jeanpri/303/pictures/04 - final assembly/IMG_6313_result.jpg

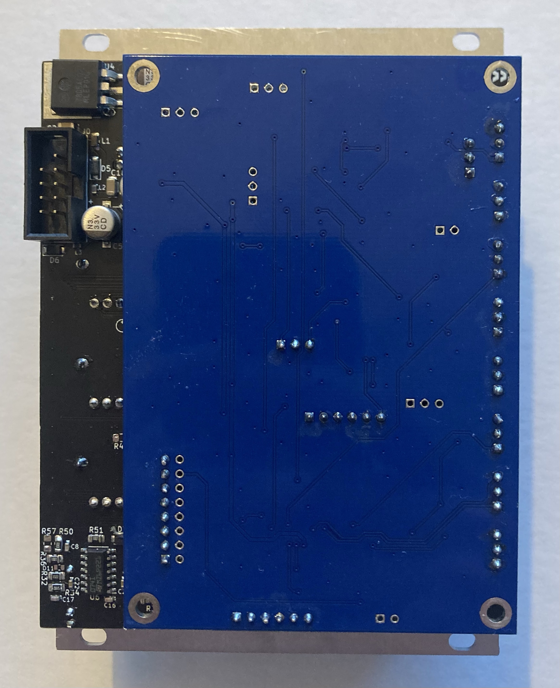
pictures/04 - final assembly/IMG_6313_result.jpg
