jeanpri/303/pictures/03 - x0x-hearth/IMG_6323_result.jpg

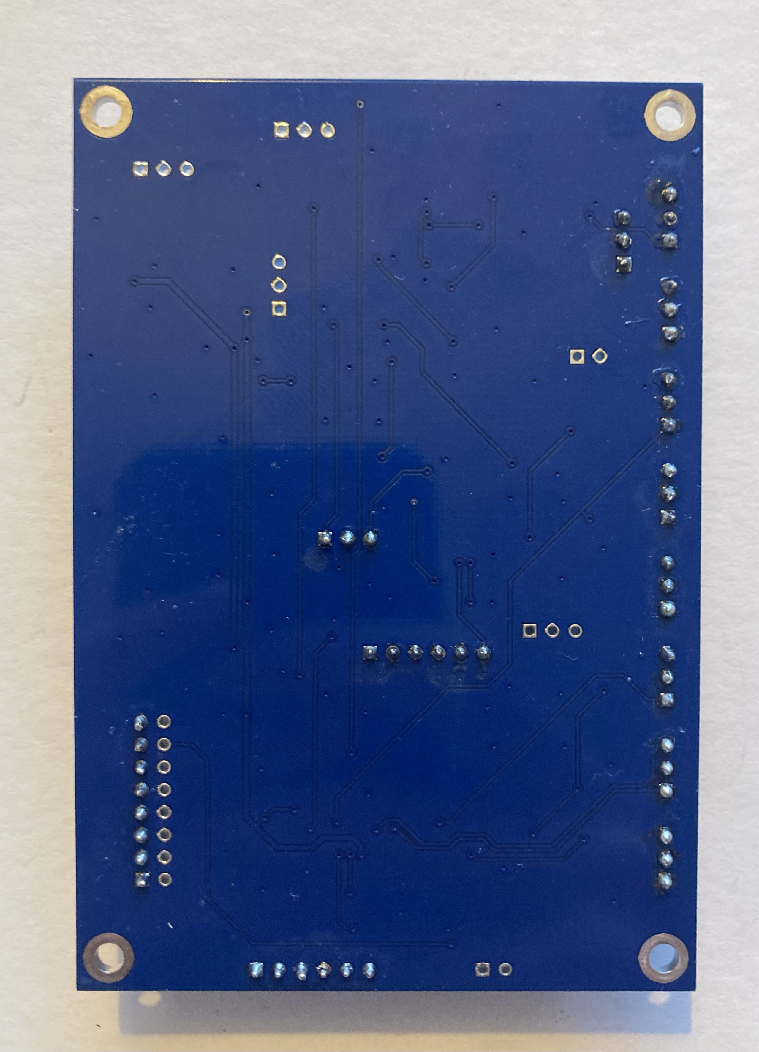
pictures/03 - x0x-hearth/IMG_6323_result.jpg
