jeanpri/303/CIRCUIT UPDATE R50 R52.pdf

## December 17, 2024

# IMPORTANT UPDATE

# Correction: Resistor Value Update

The VCA output sound was faulty: the low frequencies were filtered (the VCF output is OK).

The previously listed value of the resistor was incorrect.
R50
Incorrect Value: 330Ω
Correct Value: 51KΩ
R52
Incorrect Value: 1KΩ
Correct Value: 68KΩ

I've also updated the documentation and files in the repository to reflect this change.
