jeanpri/303/production files/interface 303/PCB info.pdf

Material: FR-4
Layers: 2
Dimension: 109mm* 90mm
Thickness: 1.6mm
Via Covering: Tented
Surface Finish: HASL(with lead)
