jeanpri/303/production files/panel 303/PCB info.pdf

Material: Aluminium (or FR-4) Layers: 1
Dimension: 128.5mm* 91.3mm Thickness: 2mm (or 1.6mm)
PCB Color : black
Silkscreen : white
