jeanpri/303/pictures/FRONT.jpg

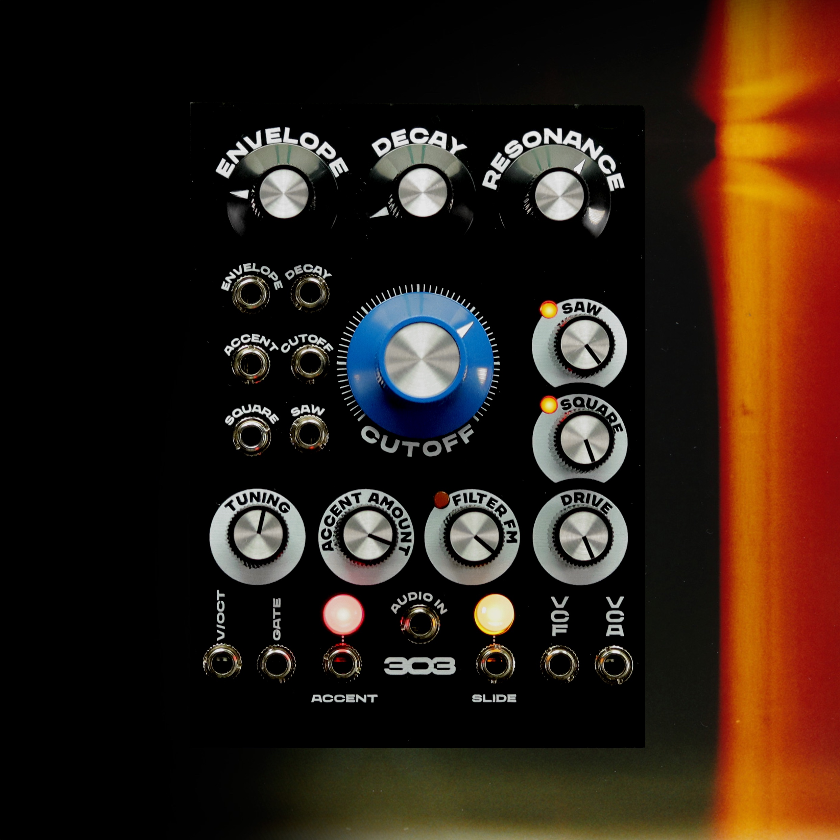
pictures/FRONT.jpg
