jeanpri/303/pictures/SIDE.jpg

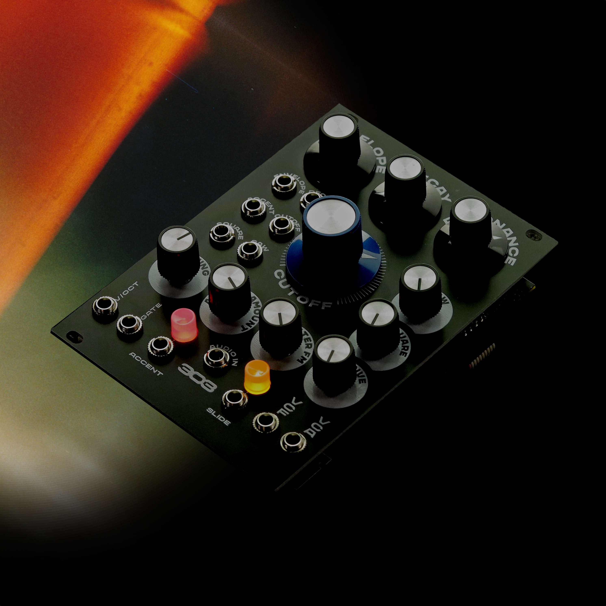
pictures/SIDE.jpg
