jeanpri/303/production files/panel 303 v2/303 panel v2.png

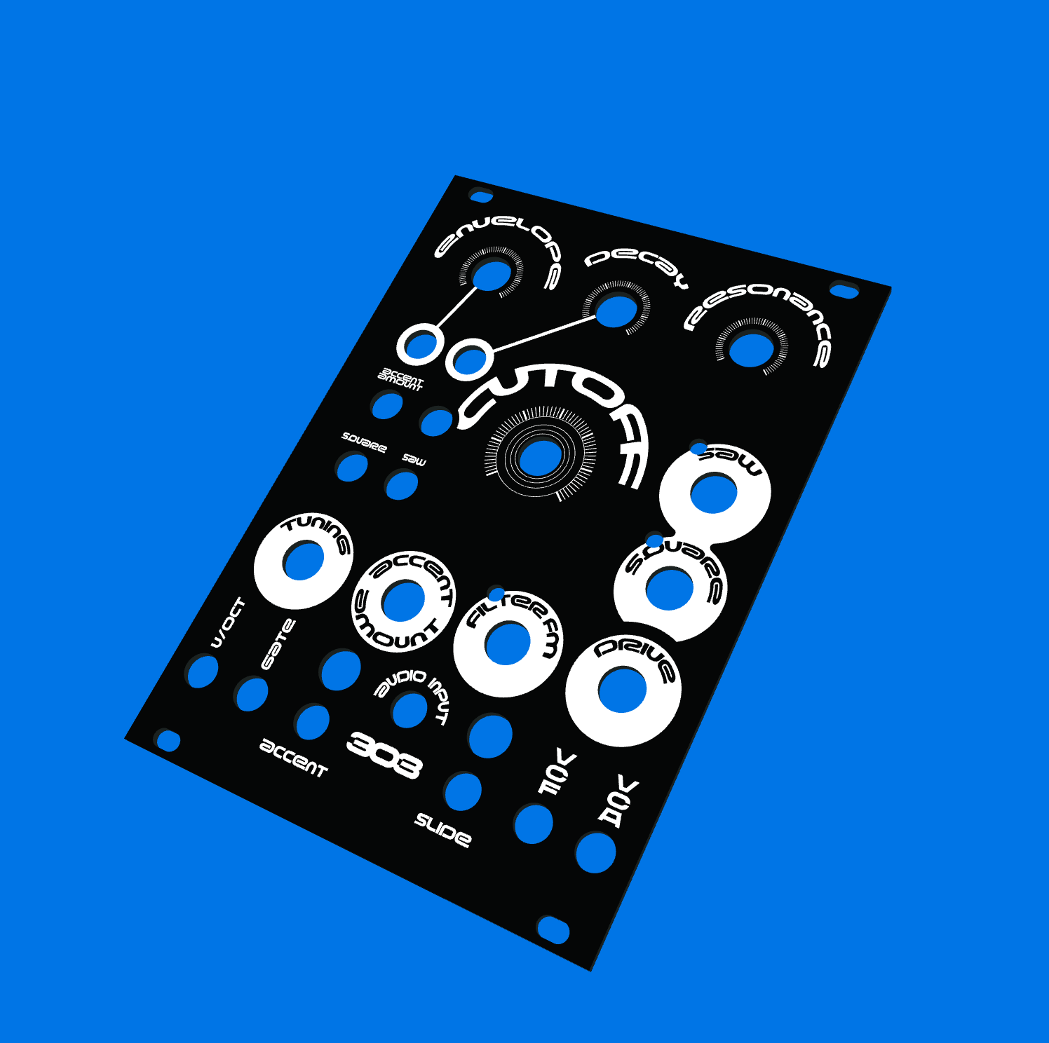
production files/panel 303 v2/303 panel v2.png
