jeanpri/303/source files/interface 303/3D bottom.png

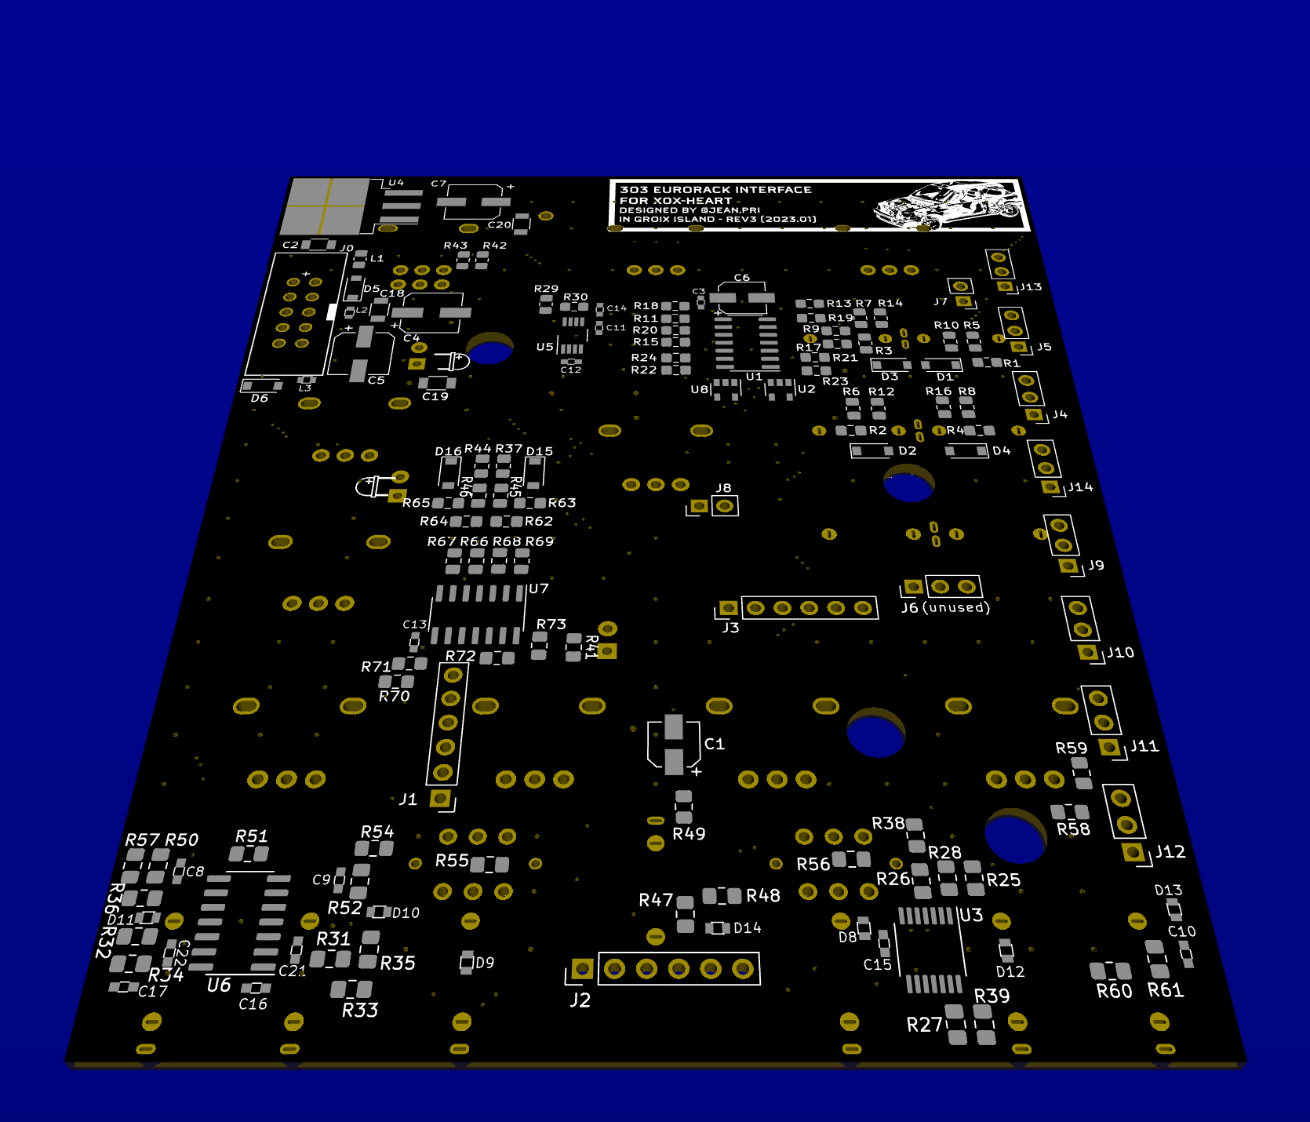
source files/interface 303/3D bottom.png
