jeanpri/303/source files/interface 303/3D top.png

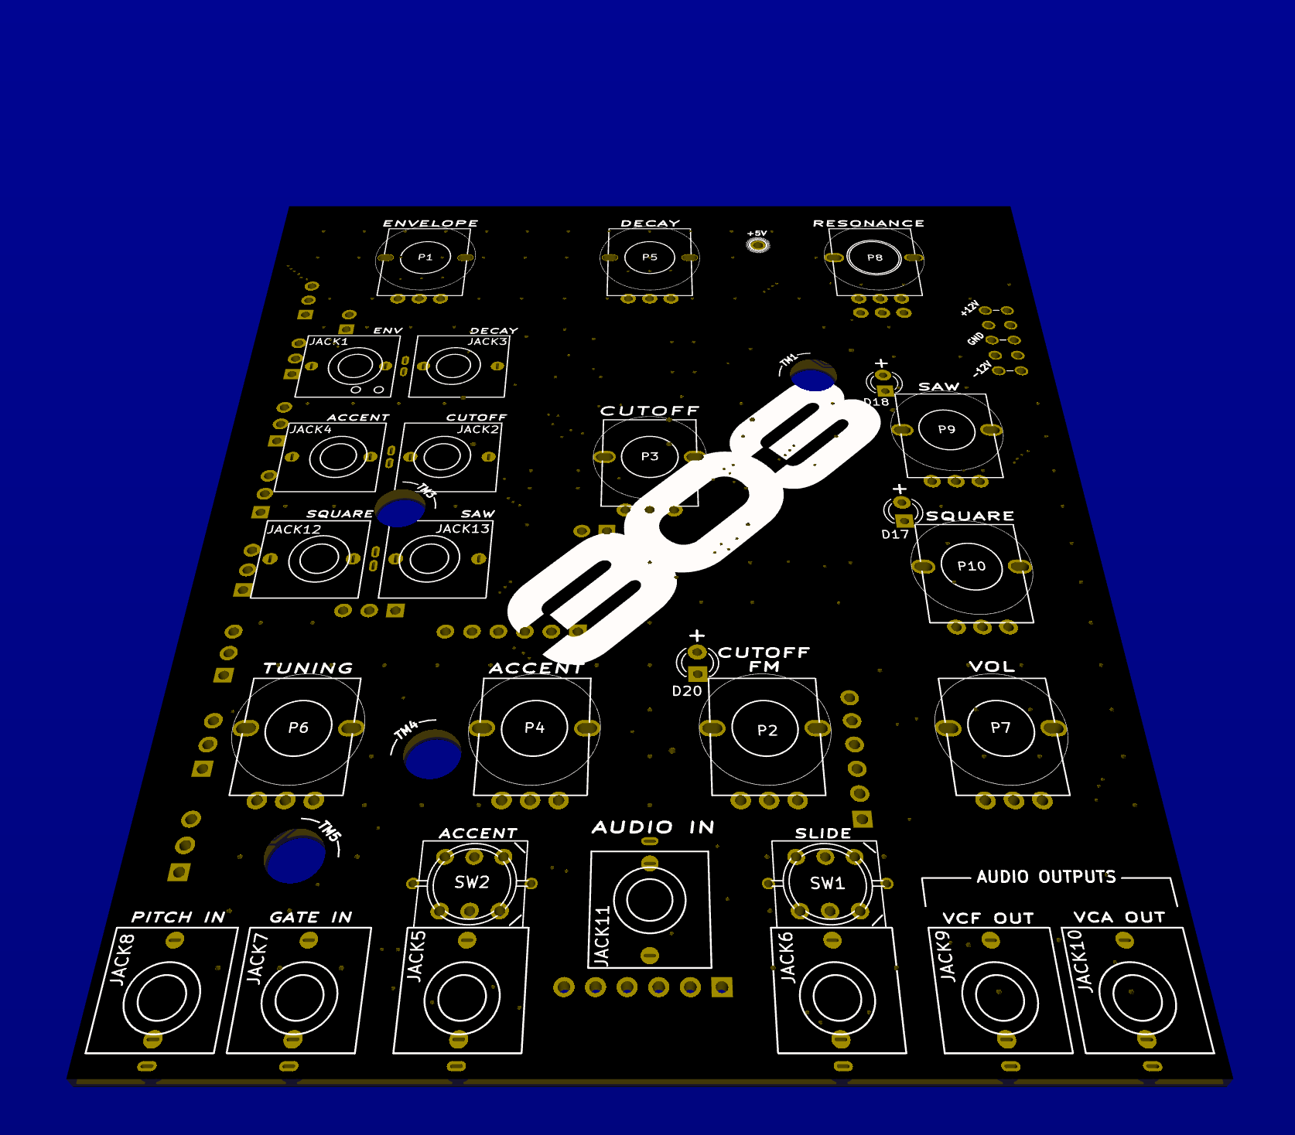
source files/interface 303/3D top.png
