jeanpri/303/production files/interface 303/BOM smd.xls

Reference / value | Designator | Footprint
LM339AMX | U7,U1 | SOIC-14_3.9x8.7mm_P1.27mm
0R | R59,R58 | 0805
68R 1% | R30 | 0805
220R 1% | R56,R55 | 0805
330R 1% | R41 | 0805
1K 1% | R54,R51,R36,R35,R72,R73 | 0805
2K2 1% | R69,R68,R32,R24,R23,R22,R21 | 0805
3K9 1% | R29 | 0805
10K 1% | R67,R66,R46,R45,R44,R37,R60,R28,R27,R26,R20,R19,R18,R17,R8,R7,R6,R5,R4,R3,R2,R1 | 0805
12K 1% | R31 | 0805
15K 1% | R61 | 0805
36K 1% | R65,R63,R16,R14,R12,R10 | 0805
47K 1% | R71,R70 | 0805
51K 1% | R64,R62,R34,R15,R13,R11,R9,R15,R50 | 0805
68K 1% | R52 | 0805
100k 1% | R48,R47,R39,R38,R33,R25 | 0805
150K 1% | R49 | 0805
220K 1% | R43 | 0805
470K 1% | R42 | 0805
100p | C9,C8,C17,C16 | 0603
4.7n | C14 | 0603
100n | C13,C10,C22,C21,C15,C12,C11,C3 | 0603
1u | C1 | CP_4x5.3
4.7uf | C6 | CP_5x5.8
22u | C20,C19,C18,C2 | 1206
47uf | C7,C5,C4 | CP_6.3x5.8
MLZ2012M330WT000 | L1 | 0805
742792664 | L3,L2 | 0603
1N4148 | D16,D15,D4,D3,D2,D1 | D_SOD-123
B72500D0160H060 | D14,D13,D12,D11,D10,D9,D8 | CERA_0603
TL074IDE4 | U6 | SOIC-14_3.9x8.7mm_P1.27mm
1N5819HW-F | D6,D5 | D_SOD-123
LM555CMMX | U5 | VSSOP-8_3.0x3.0mm_P0.65mm
MC7805ACD2TR4G | U4 | TO-263-3_TabPin2
M74HC14YTTR | U3 | TSSOP-14_4.4x5mm_P0.65mm
74AHC1G08 | U8 | SOT-23-5
SN74AHC1G00 | U2 | SOT-23-5
