jeanpri/303/production files/interface 303/BOM  through-hole.xls

For HMI PCB
Quantity | Reference / value | Designator | Footprint
13 | PJ398SM | JACK4,JACK13,JACK12,JACK3,JACK2,JACK1, JACK11,JACK10,JACK9,JACK8,JACK7,JACK6,JACK5 | Thonkiconn | https://www.thonk.co.uk/shop/thonkiconn/
1 | 30310-6002HB | J0 | 30310-6002HB | https://mou.sr/48e72rY
2 | LP4EE1PBCTY | SW1,SW2 | LP4EE1PBCTY | https://mou.sr/41ID3FZ
13 | 801-87-010-10-001101 | J8,J7,J14,J13,J12,J11,J10,J9,J5,J4,J3,J2,J1 | PinHeader_2.54mm_Vertical_female | https://mou.sr/3TNIDVw | note : you can buy only 5 units of this 10-pin connector, as you can cut them into smaller parts
13 | M20-9992046 | J8,J7,J14,J13,J12,J11,J10,J9,J5,J4,J3,J2,J1 (x0x-heart side) | PinHeader_2.54mm_Vertical_male | https://mou.sr/3RI76ca | note : you can buy only 3 units of this 20-pin connector, as you can cut them into smaller parts
3 | WP424EDT | D18,D17,D20 | LED_D3.0mm | https://mou.sr/47aP9ZK
1 | B50K - DUAL GANG – Round Shaft 6.35mm - Alpha Vertical 9mm Potentiometer | P8 | Alpha9mm DUAL GANG | https://www.thonk.co.uk/shop/alpha-9mm-pots/
3 | A50K - Round Shaft 6.35mm - Alpha Vertical 9mm Potentiometer | P7,P3,P1 | Alpha9mm | https://www.thonk.co.uk/shop/alpha-9mm-pots/
1 | A1M - Round Shaft 6.35mm - Alpha Vertical 9mm Potentiometer | P5 | Alpha9mm | https://www.thonk.co.uk/shop/alpha-9mm-pots/
5 | B50K - Round Shaft 6.35mm - Alpha Vertical 9mm Potentiometer | P2,P10,P9,P6,P4 | Alpha9mm | https://www.thonk.co.uk/shop/alpha-9mm-pots/
For Panel
Quantity | Reference / value | Designator | Footprint
1 | Knurled Nuts (Bag of 50 pieces) |  |  | https://www.thonk.co.uk/shop/thonkiconn/
6 | Small - Rogan RB Plastic Knob |  |  | https://www.thonk.co.uk/shop/rogan-buchla/ | note : I also recommend to buy the "Hex Key for Small Knobs" and the "Hex Key for Medium Knobs" on this same page, it will be easier to screw these knobs
3 | Small Skirt - Rogan RB Plastic Knob |  |  | https://www.thonk.co.uk/shop/rogan-buchla/
1 | Medium Skirt - Rogan RB Plastic Knob |  |  | https://www.thonk.co.uk/shop/rogan-buchla/
