jeanpri/303/manual.pdf

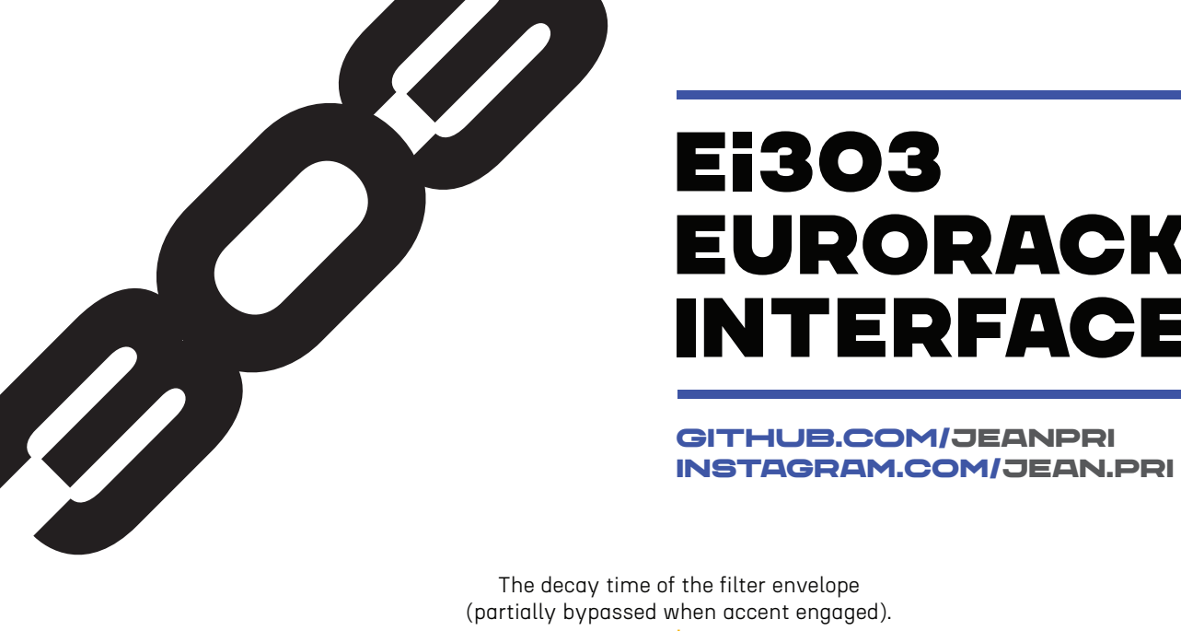
[picture p16: figure]
The decay time of the filter envelope (partially bypassed when accent engaged).; github.com/jeanpri instagram.com/jean.pri
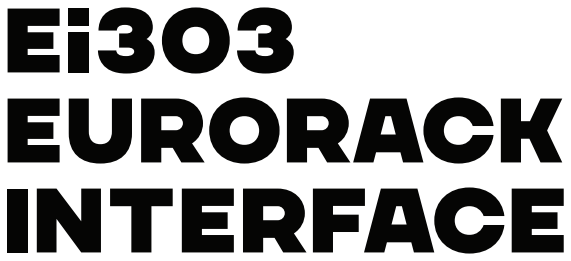
[picture p17: figure]
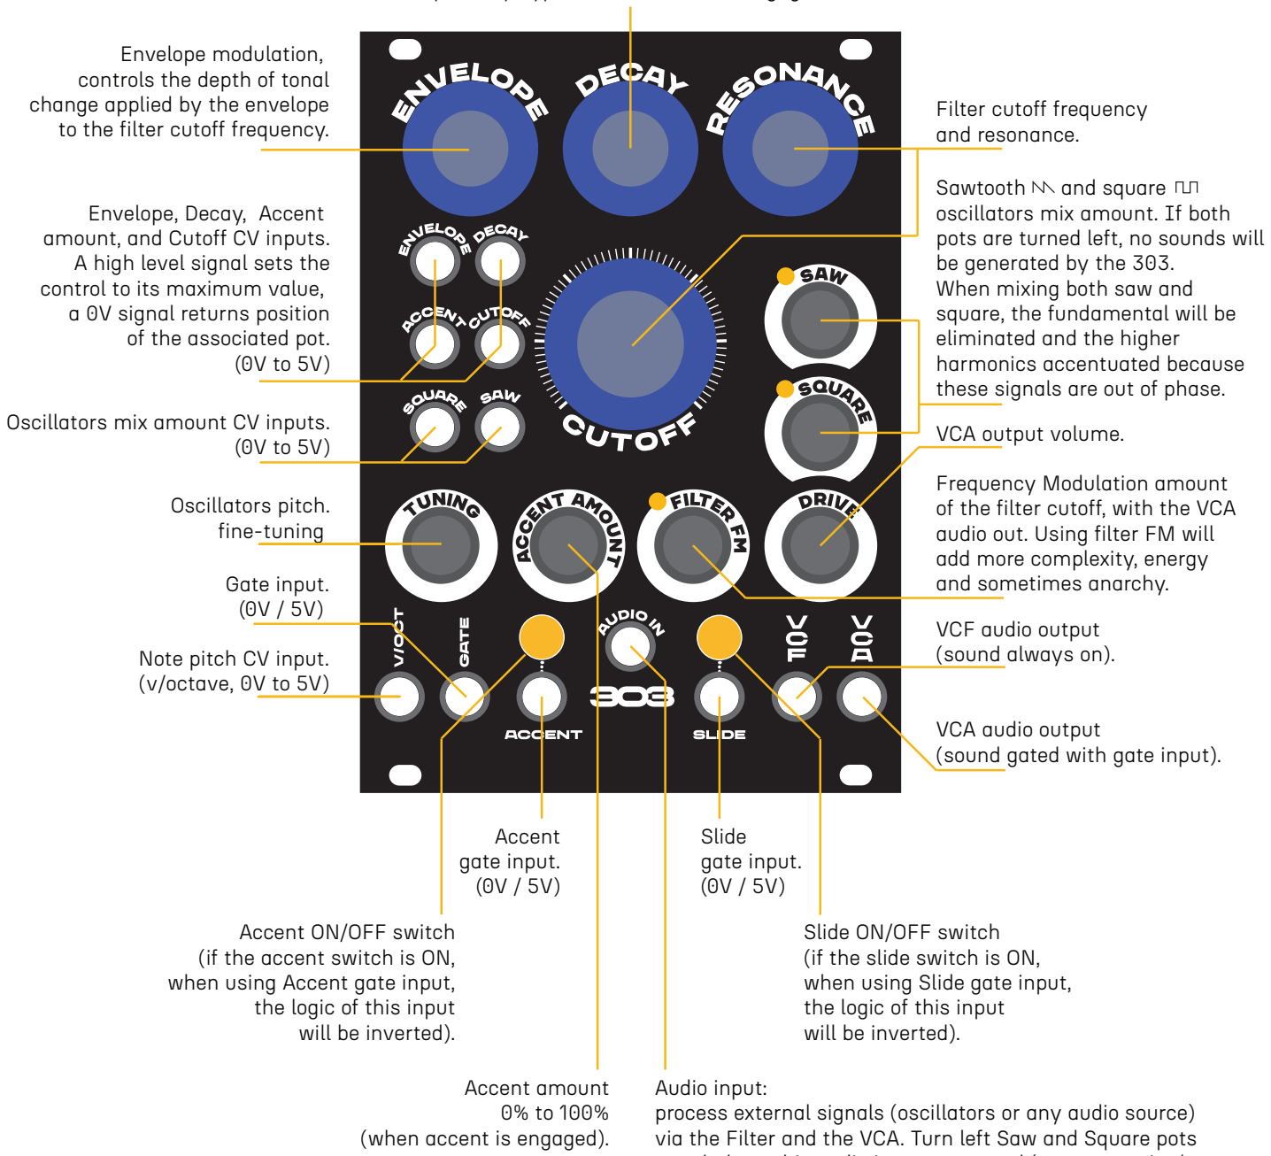
[picture p18: figure]
IIIIIIIIIIIIIIIIIIIIIIIIIIIIIIIIIIIIIIIIIIIIIIIIIIIIIIIIIIIII; Sawtooth; and square; oscillators mix amount. If both pots are turned left, no sounds will be generated by the 303. When mixing both saw and square, the fundamental will be eliminated and the higher harmonics accentuated because these signals are out of phase.; VCA output volume.; Filter cutoff frequency and resonance.; VCA audio output (sound gated with gate input).; VCF audio output; Note pitch CV input.; (sound always on).; (v/octave, 0V to 5V); Gate input. (0V / 5V); Accent gate input. (0V / 5V); Slide gate input. (0V / 5V)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

process external signals (oscillators or any audio source) via the Filter and the VCA. Turn left Saw and Square pots to only hear this audio input processed (you must trig the gate input, as the signal pass into the VCA).
