jeanpri/303/source files/interface 303/PCB - PRINTING - BOTTOM.pdf

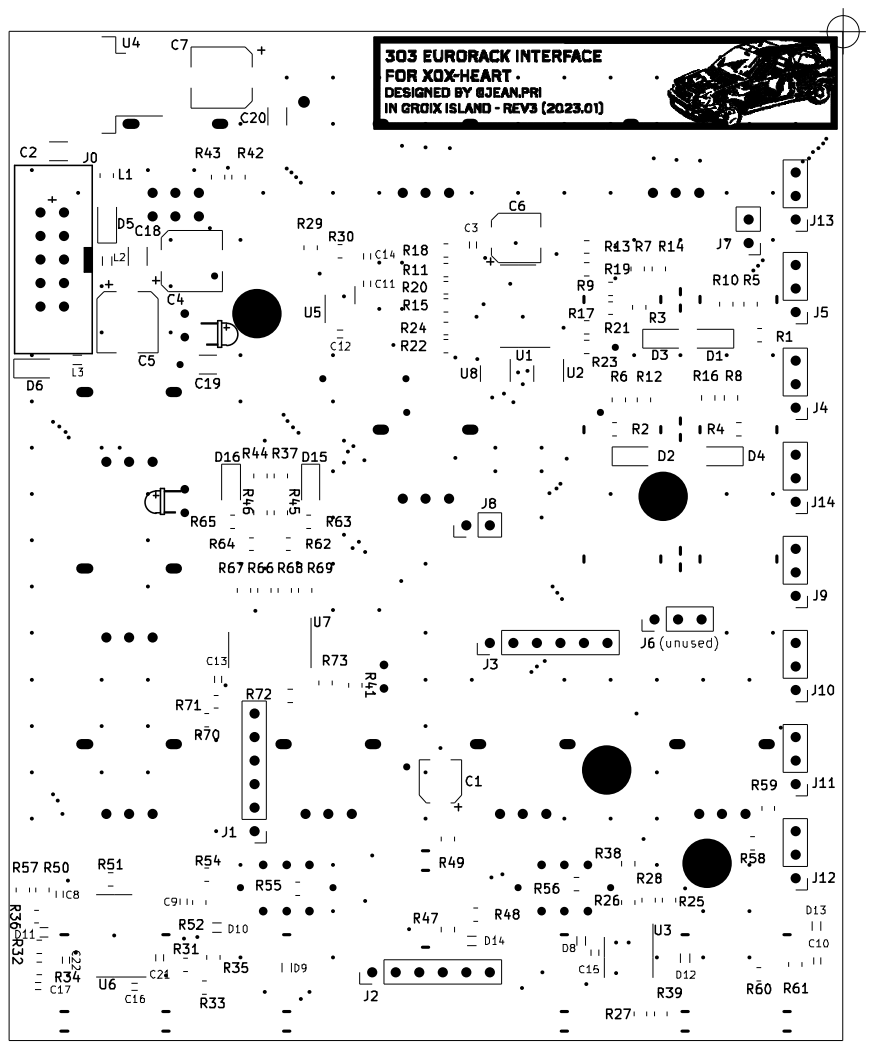
[picture p20: page 1]
