jeanpri/303/source files/interface 303/PCB - PRINTING - TOP.pdf

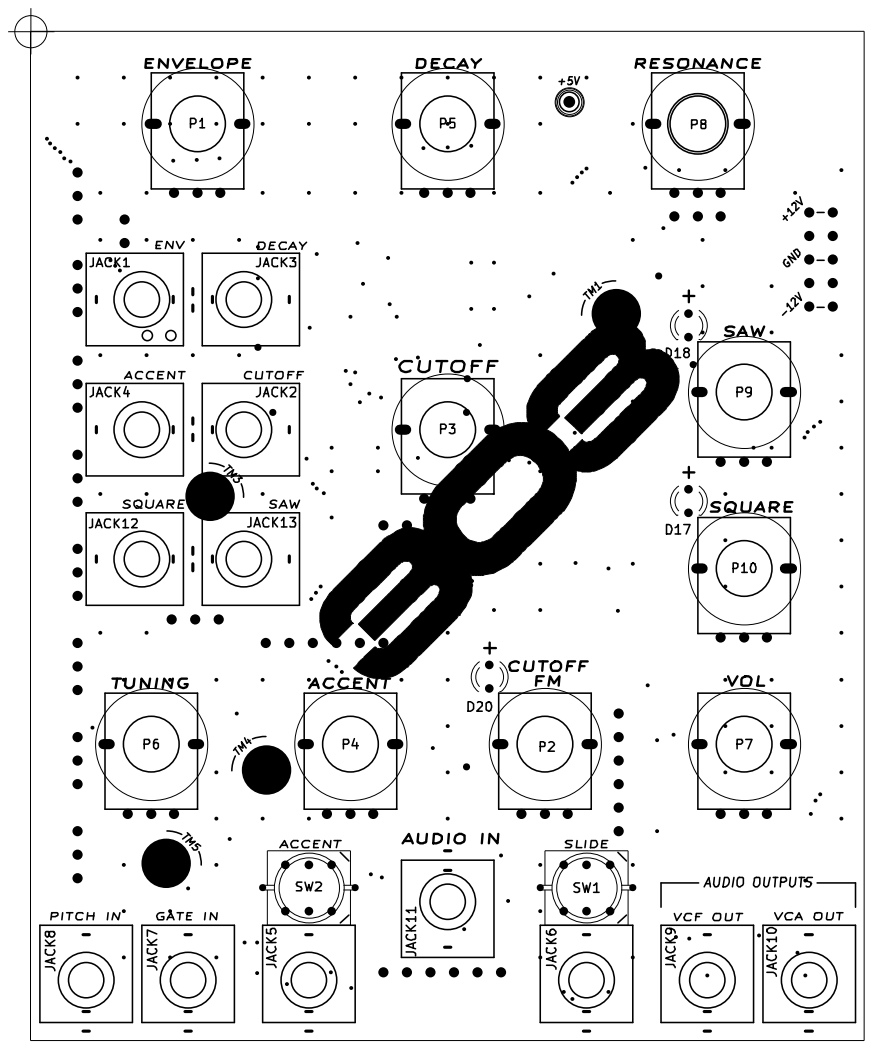
[picture p21: page 1]
