jeanpri/303/source files/interface 303/schematic.pdf

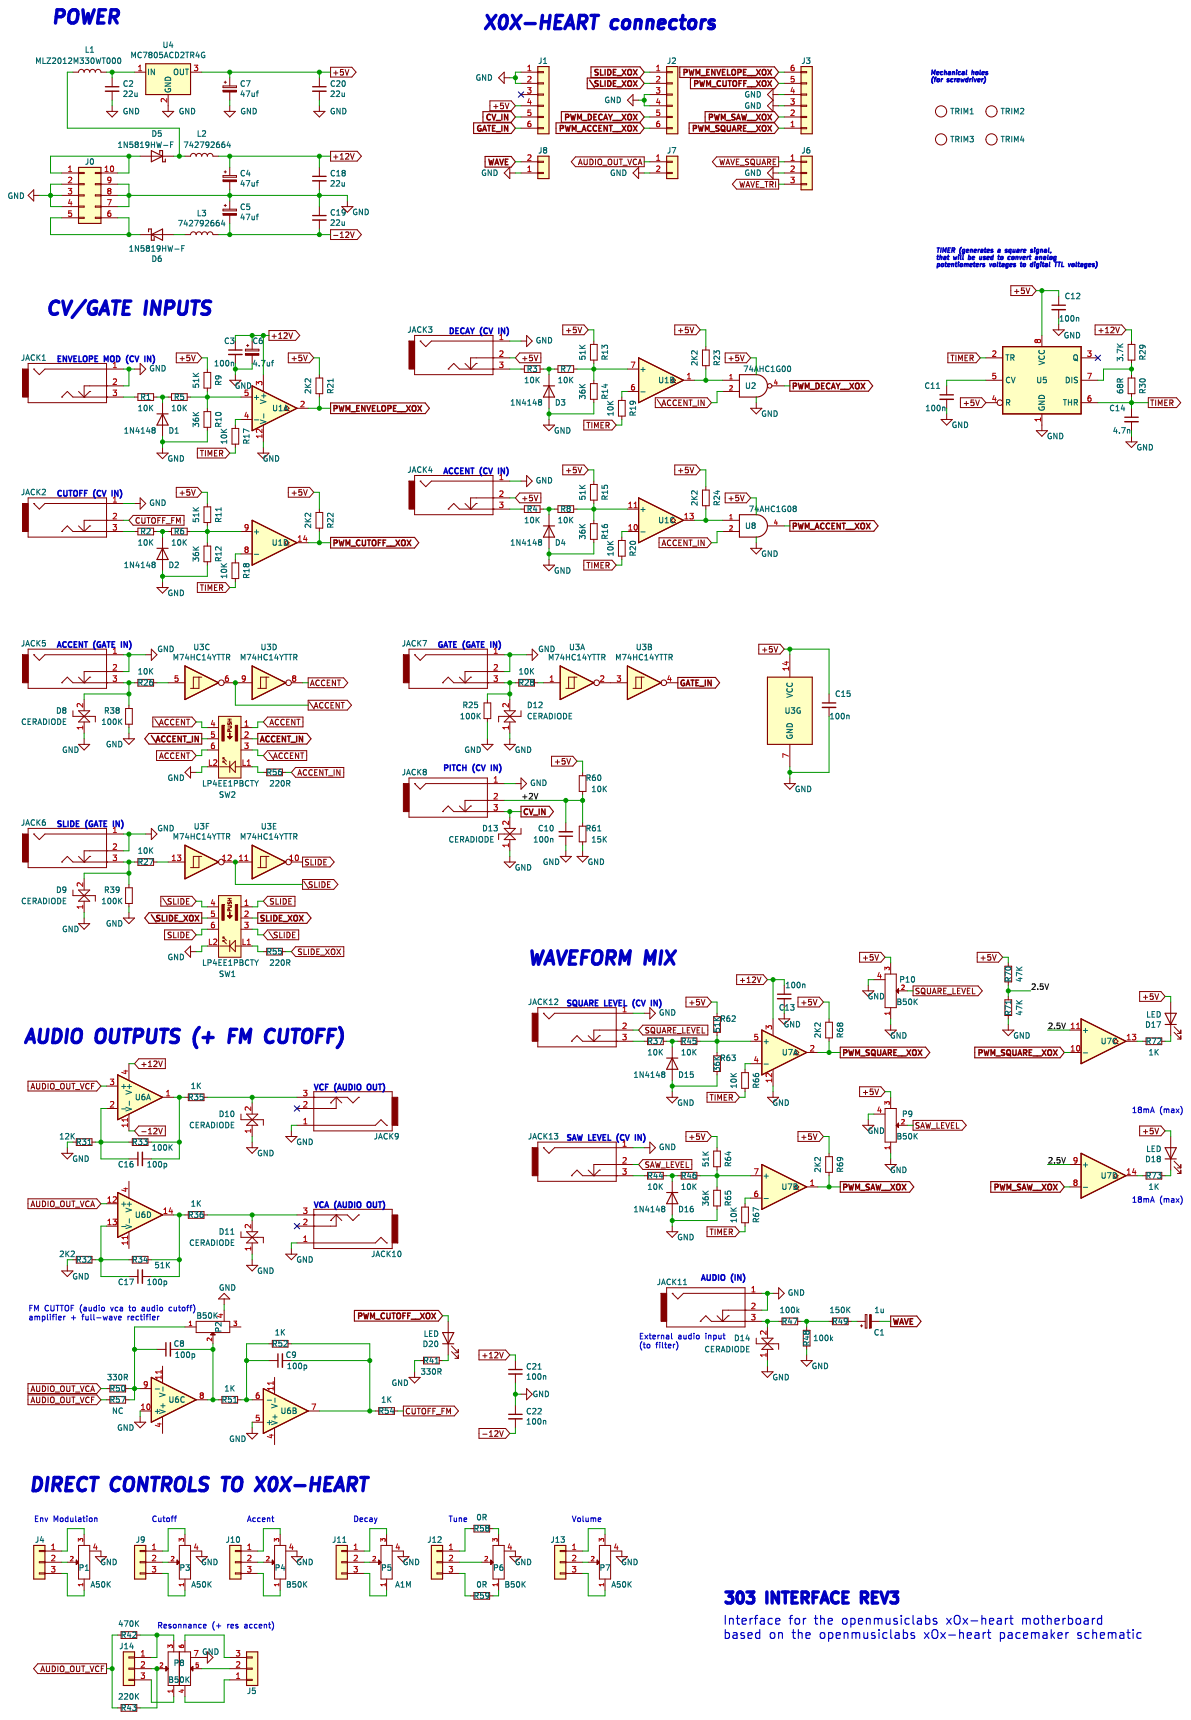
[picture p22: page 1]
