jeanpri/303/source files/interface 303/PCB - COPPER - BOTTOM.pdf

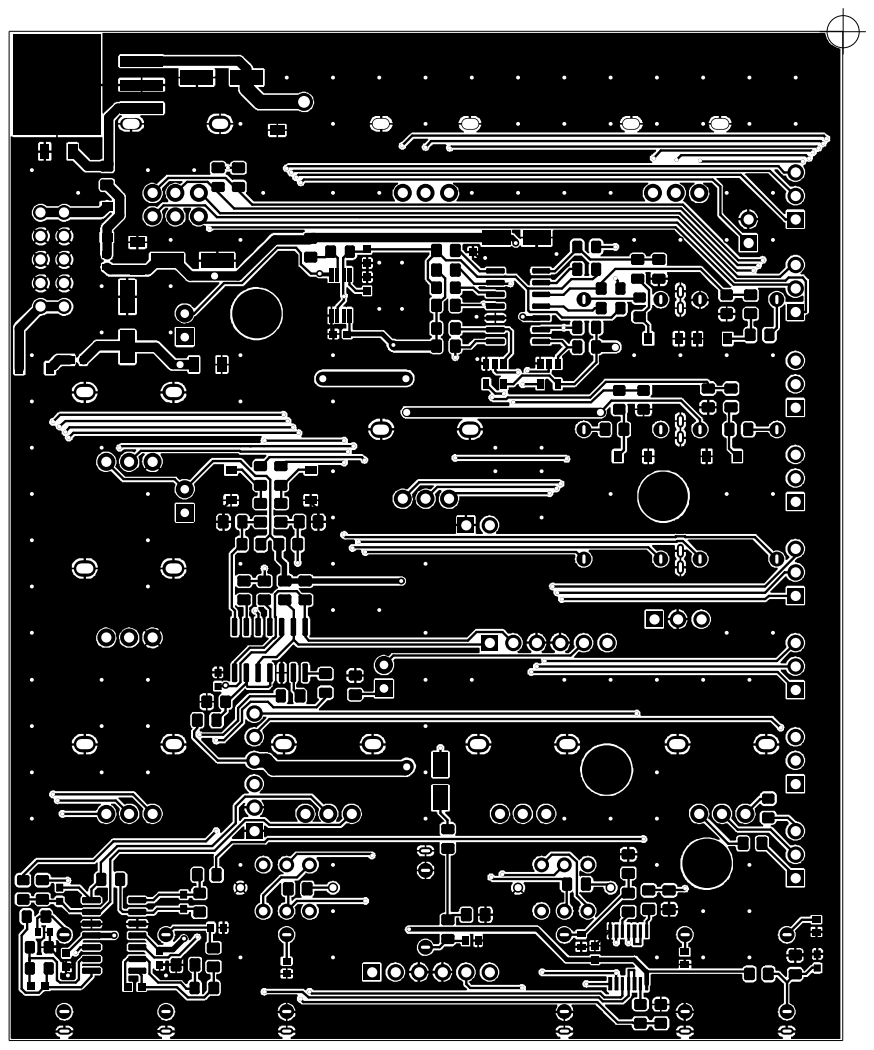
[picture p23: page 1]
