jeanpri/303/source files/interface 303/PCB - COPPER - TOP.pdf

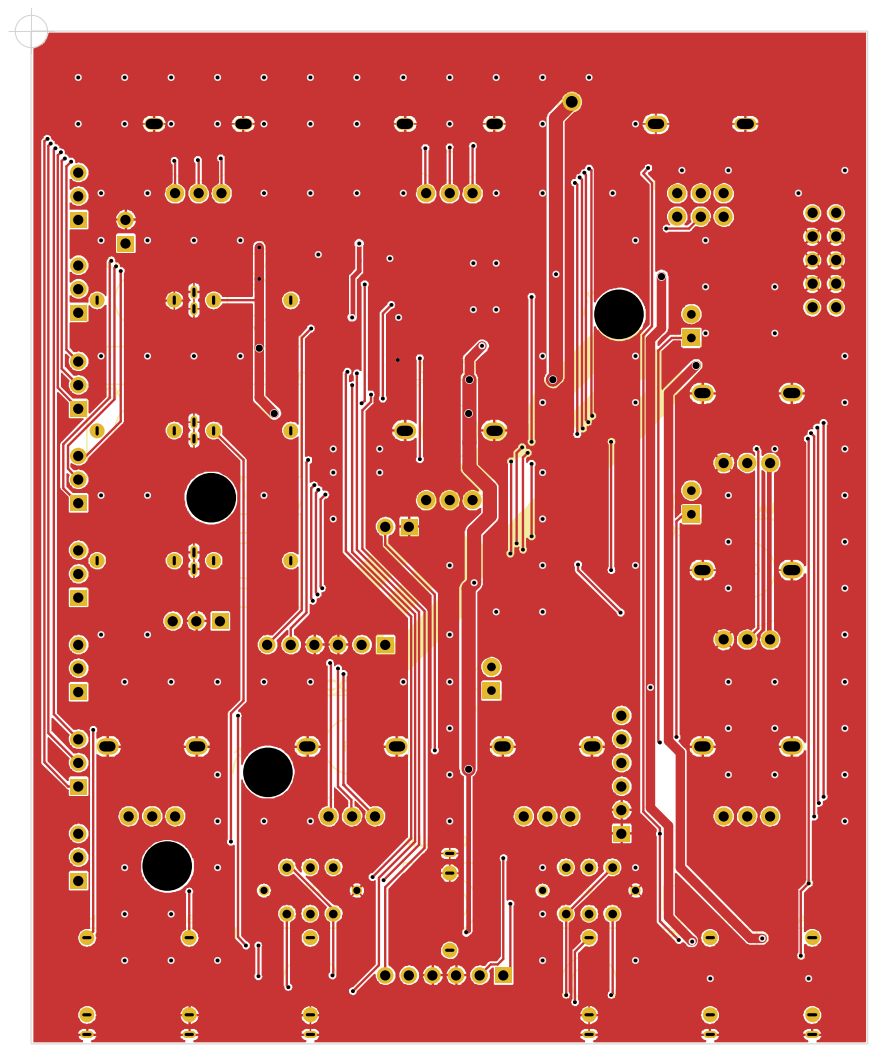
[picture p24: page 1]
