jeanpri/303/source files/panel 303/panel.pdf

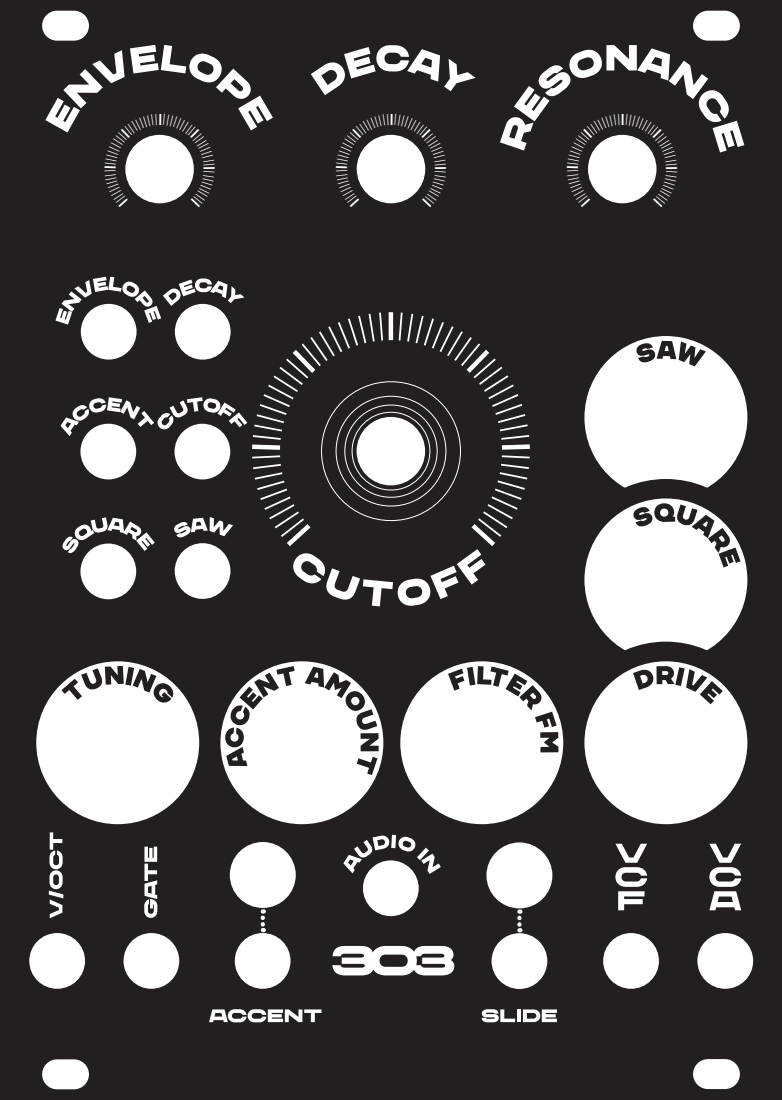
[picture p25: page 1]
IIIIIIIIIIIIIIIIIIIIIIIIIII; I I I IIIIIIIIIIIIIIIIIIIIIIIIIIII
