jeanpri/303/source files/interface 303/kicad/303.kicad_pcb

## KiCad design source files/interface 303/kicad/303.kicad_pcb (2024-12-17)

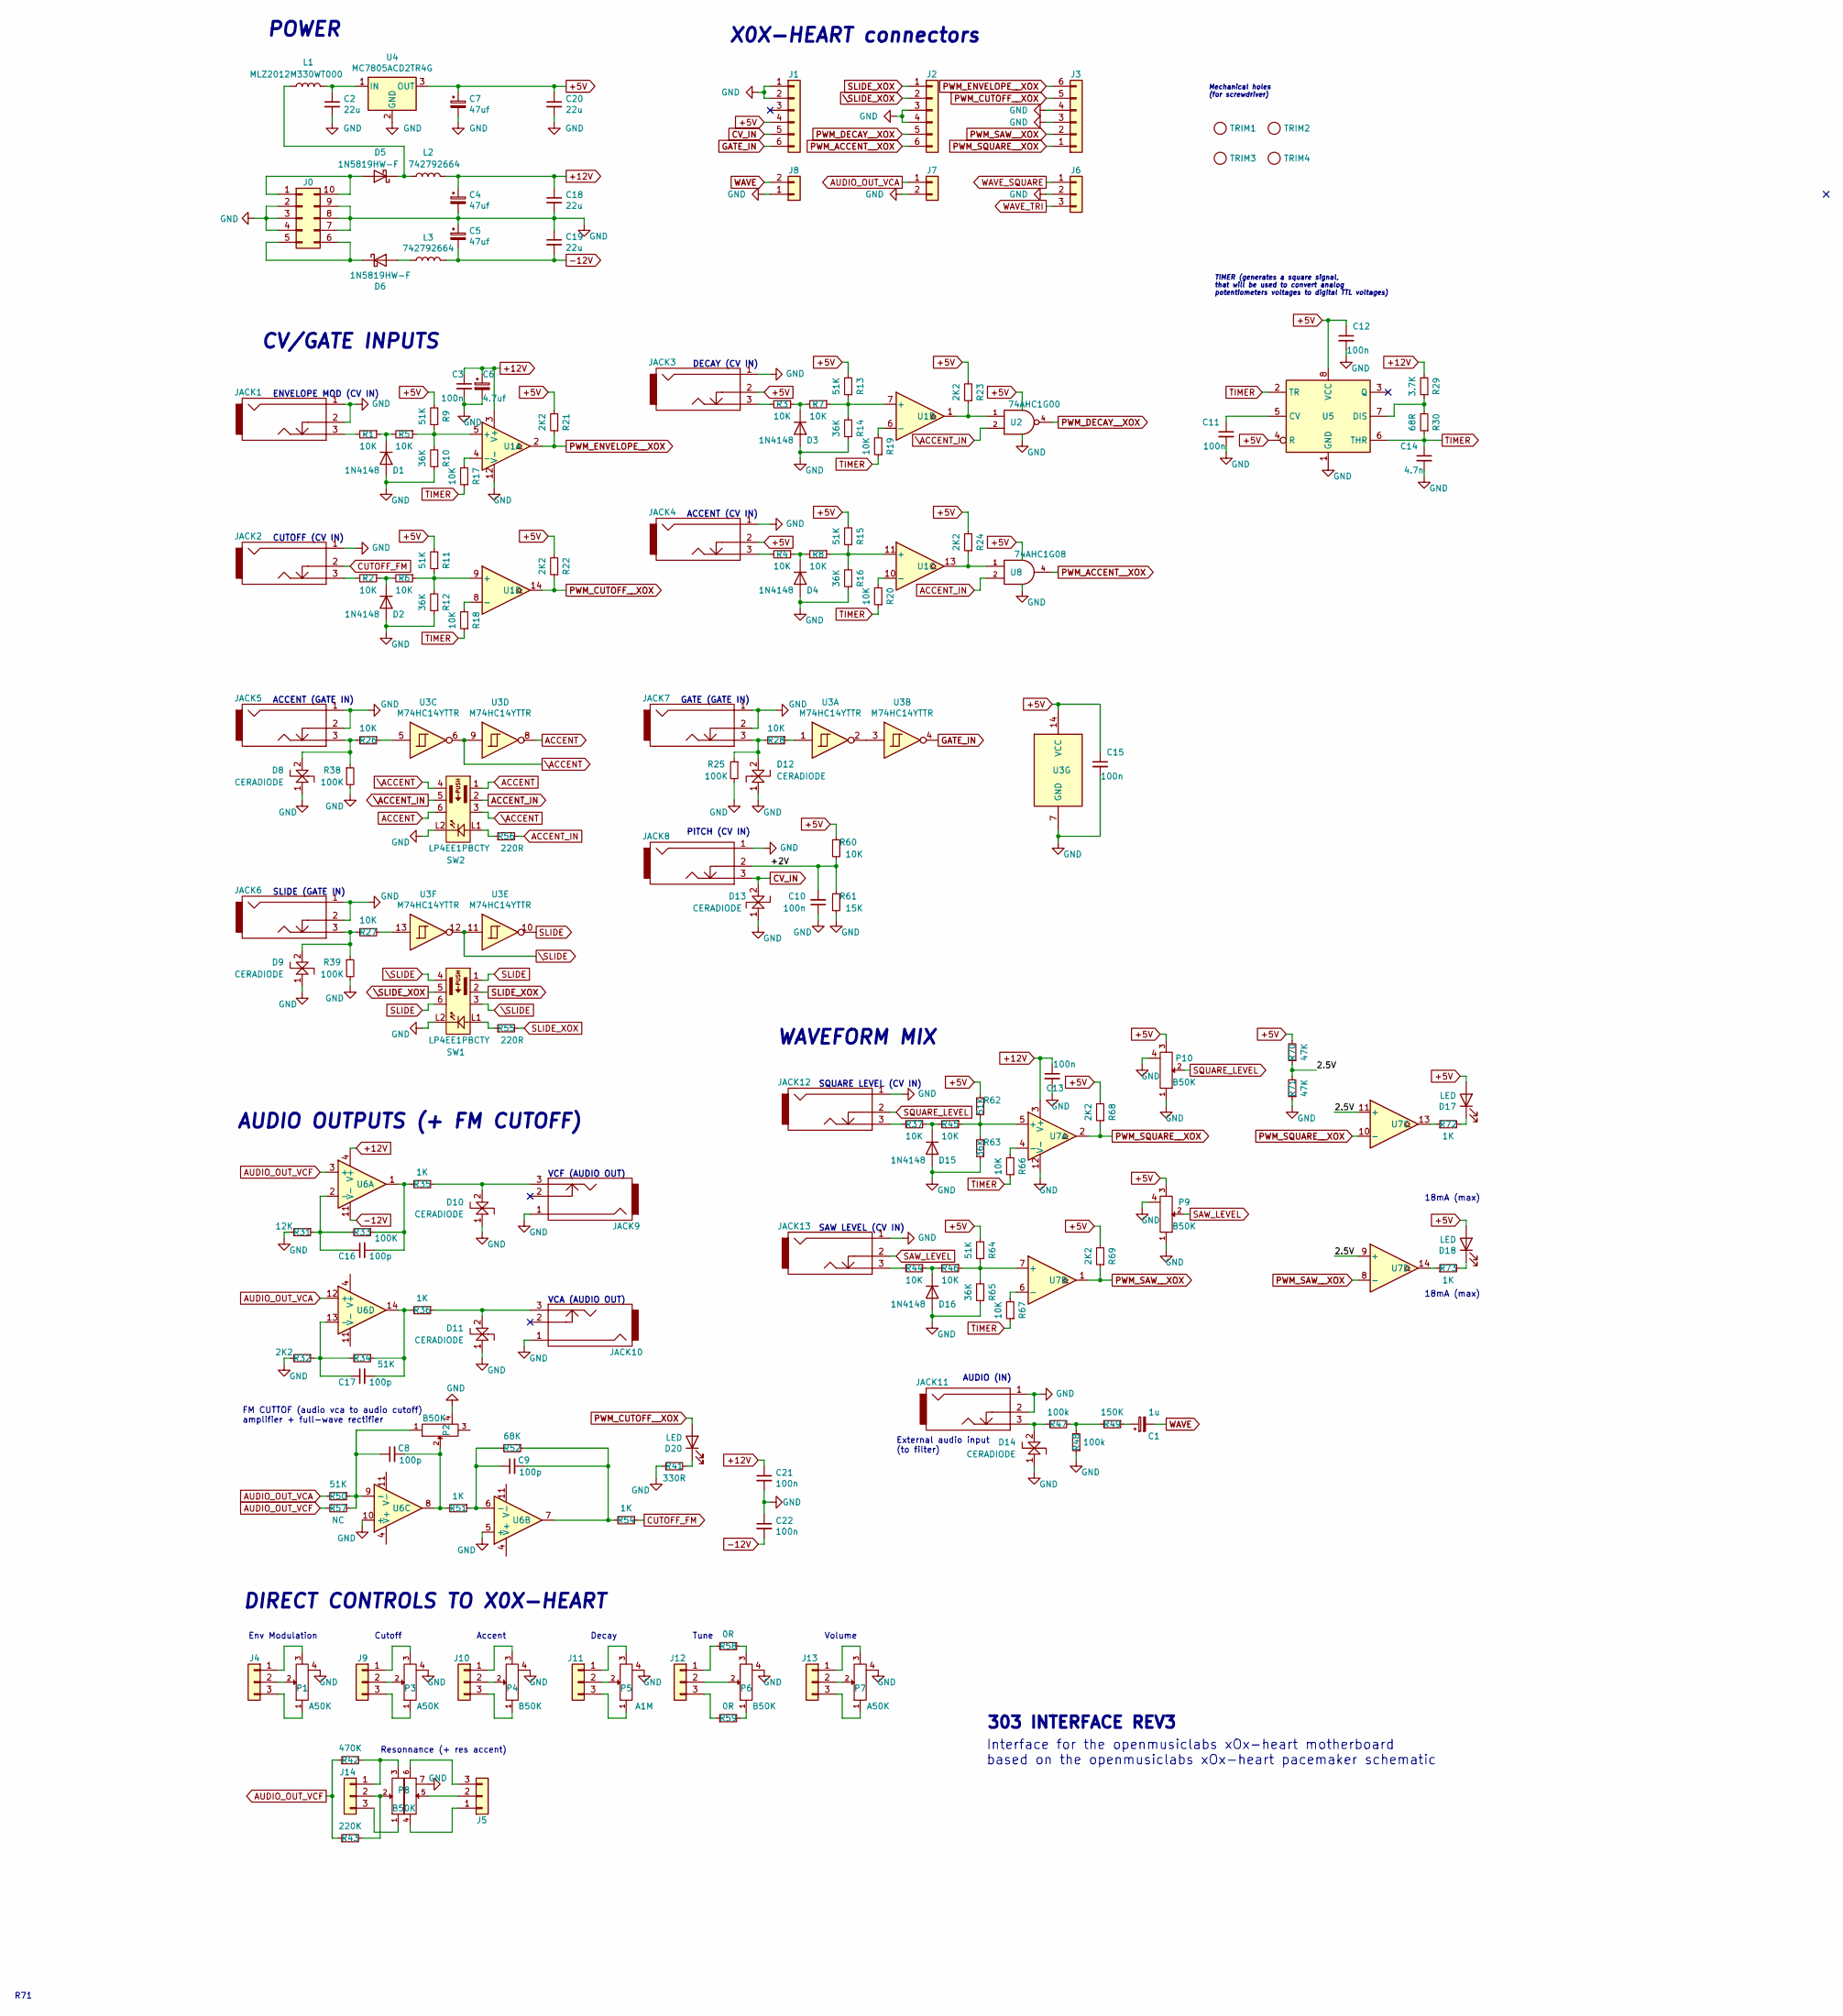
[picture p26: schematic 303.kicad_sch]

Parts:
C1: 1u; CP_4x5.3
C2, C18, C19, C20: 22u; C_1206
C3, C10, C11, C12, C13, C15, C21, C22: 100n; C_0603
C4, C5, C7: 47uf; CP_6.3x5.8
C6: 4.7uf; CP_5x5.8
C8, C9, C16, C17: 100p; C_0603
C14: 4.7n; C_0603
D1, D2, D3, D4, D15, D16: 1N4148; D_SOD-123
D5, D6: 1N5819HW-F; D_SOD-123
D8, D9, D10, D11, D12, D13, D14: CERADIODE; CERA_0603
D17, D18, D20: LED; LED_D3.0mm
J0: 30310-6002HB
J1, J2, J3: Conn_01x06; PinHeader_1x06_P2.54mm_Vertical
J4, J5, J6, J9, J10, J11, J12, J13, J14: Conn_01x03; PinHeader_1x03_P2.54mm_Vertical
J7, J8: Conn_01x02; PinHeader_1x02_P2.54mm_Vertical
JACK1, JACK2, JACK3, JACK4, JACK12, JACK13: PJ398SM-BLACK; Thonkiconn_small_head_to_head
JACK5, JACK6, JACK7, JACK8, JACK9, JACK10, JACK11: PJ398SM-BLACK; Thonkiconn_small
L1: MLZ2012M330WT000; R_0805
L2, L3: 742792664; R_0603
P1, P3, P7: A50K; Alpha9mm
P2, P4, P6, P9, P10: B50K; Alpha9mm
P5: A1M; Alpha9mm
P8: B50K; Alpha9mm_dual
R1, R2, R3, R4, R5, R6, R7, R8, R17, R18, R19, R20, R26, R27, R28, R37, R44, R45, R46, R60, R66, R67: 10K; R_0805
R9, R11, R13, R15, R34, R50, R62, R64: 51K; R_0805
R10, R12, R14, R16, R63, R65: 36K; R_0805
R21, R22, R23, R24, R32, R68, R69: 2K2; R_0805
R25, R33, R38, R39: 100K; R_0805
R29: 3.7K; R_0805
R30: 68R; R_0805
R31: 12K; R_0805
R35, R36, R51, R54, R72, R73: 1K; R_0805
R41: 330R; R_0805
R42: 470K; R_0805
R43: 220K; R_0805
R47, R48: 100k; R_0805
R49: 150K; R_0805
R52: 68K; R_0805
R55, R56: 220R; R_0805
R57: NC; R_0805
R58, R59: 0R; R_0805
R61: 15K; R_0805
R70, R71: 47K; R_0805
SW1, SW2: LP4EE1PBCTY; LP4EE1PBCT
TRIM1, TRIM2, TRIM3, TRIM4: TRIM; HOLE_5_2mm
U1, U7: LM339AMX/NOPB; SOIC-14_3.9x8.7mm_P1.27mm
U2: 74AHC1G00; SOT-23-5
U3: M74HC14YTTR; TSSOP-14_4.4x5mm_P0.65mm
U4: MC7805ACD2TR4G; TO-263-3_TabPin2
U5: LM555CMMX/NOPB; VSSOP-8_3.0x3.0mm_P0.65mm
U6: TL074IDE4; SOIC-14_3.9x8.7mm_P1.27mm
U8: 74AHC1G08; SOT-23-5

Connections:
+5V: C7.1, C12.1, C15.1, C20.1, D17.2 (A), D18.2 (A), J1.4, JACK3.2, JACK4.2, P9.3, P10.3, R9.2, R11.2, R13.2, R15.2, R21.2, R22.2, R23.2, R24.2, R60.1, R62.2, R64.2, R68.2, R69.2, R70.2, U2.5 (VCC), U3.14 (VCC), U4.3 (OUT), U5.4 (R), U5.8 (VCC), U8.5 (VCC)
+12V: C3.1, C4.1, C6.1, C13.1, C18.1, C21.1, L2.2, R29.2, U1.3 (V+), U6.4 (V+), U7.3 (V+)
-12V: C5.2, C19.2, C22.2, L3.2, U6.11 (V-)
/2.5V: R70.1, R71.2, U7.9 (+), U7.11 (+)
/+2V: C10.2, JACK8.2, R60.2, R61.1
ACCENT: SW2.1, SW2.6, U3.8
ACCENT_IN: R56.2, SW2.2, U8.2
AUDIO_OUT_VCA: J7.1, R50.2, U6.12 (+)
AUDIO_OUT_VCF: R42.1, R43.1, R57.2, U6.3 (+)
CUTOFF_FM: JACK2.2, R54.1
CV_IN: D13.2, J1.5, JACK8.3
GATE_IN: J1.6, U3.4
GND: C2.2, C3.2, C4.2, C5.1, C6.2, C7.2, C10.1, C11.2, C12.2, C13.2, C14.2, C15.2, C18.2, C19.1, C20.2, C21.2, C22.1, D1.2 (A), D2.2 (A), D3.2 (A), D4.2 (A), D8.1, D9.1, D10.1, D11.1, D12.1, D13.1, D14.1, D15.2 (A), D16.2 (A), J0.2, J0.3, J0.4, J0.7, J0.8, J0.9, J1.1, J1.2, J2.3, J2.4, J3.3, J3.4, J6.2, J7.2, J8.1, JACK1.1, JACK1.2, JACK2.1, JACK3.1, JACK4.1, JACK5.1, JACK5.2, JACK6.1, JACK6.2, JACK7.1, JACK7.2, JACK8.1, JACK9.1, JACK10.1, JACK11.1, JACK11.2, JACK12.1, JACK13.1, P1.4 (shield), P2.4 (shield), P3.4 (shield), P4.4 (shield), P5.4 (shield), P6.4 (shield), P7.4 (shield), P8.7 (shield), P9.1, P9.4 (shield), P10.1, P10.4 (shield), R10.1, R12.1, R14.1, R16.1, R25.2, R31.2, R32.2, R38.2, R39.2, R41.1, R48.1, R61.2, R63.1, R65.1, R71.1, SW1.L2, SW2.L2, U1.12 (V-), U2.3 (GND), U3.7 (GND), U4.2 (GND), U5.1 (GND), U6.5 (+), U6.10 (+), U7.12 (V-), U8.3 (GND)
unnamed: C1.1, R49.1
unnamed: C8.2, P2.2, R51.2, U6.8
unnamed: C9.2, R52.1, R54.2, U6.7
unnamed: C16.2, R33.1, R35.2, U6.1
unnamed: C17.2, R34.1, R36.2, U6.14
unnamed: D1.1 (K), R1.1, R5.2
unnamed: D2.1 (K), R2.1, R6.2
unnamed: D3.1 (K), R3.1, R7.2
unnamed: D4.1 (K), R4.1, R8.2
unnamed: D5.2 (A), J0.1, J0.10
unnamed: D5.1 (K), L1.1, L2.1
unnamed: D6.2 (A), L3.1
unnamed: D6.1 (K), J0.5, J0.6
unnamed: D8.2, JACK5.3, R26.2, R38.1
unnamed: D9.2, JACK6.3, R27.2, R39.1
unnamed: D10.2, JACK9.3, R35.1
unnamed: D11.2, JACK10.3, R36.1
unnamed: D12.2, JACK7.3, R25.1, R28.2
unnamed: D14.2, JACK11.3, R47.2
unnamed: D15.1 (K), R37.1, R45.2
unnamed: D16.1 (K), R44.1, R46.2
unnamed: D17.1 (K), R72.2
unnamed: D18.1 (K), R73.2
unnamed: D20.1 (K), R41.2
unnamed: J4.1, P1.3
unnamed: J4.2, P1.2
unnamed: J4.3, P1.1
unnamed: J5.1, P8.4
unnamed: J5.2, P8.5
unnamed: J5.3, P8.6
unnamed: J9.1, P3.3
unnamed: J9.2, P3.2
unnamed: J9.3, P3.1
unnamed: J10.1, P4.3
unnamed: J10.2, P4.2
unnamed: J10.3, P4.1
unnamed: J11.1, P5.3
unnamed: J11.2, P5.2
unnamed: J11.3, P5.1
unnamed: J12.1, R58.1
unnamed: J12.2, P6.2
unnamed: J12.3, R59.1
unnamed: J13.1, P7.3
unnamed: J13.2, P7.2
unnamed: J13.3, P7.1
unnamed: J14.1, P8.3, R42.2
unnamed: J14.2, P8.2, R43.2
unnamed: J14.3, P8.1
unnamed: JACK1.3, R1.2
unnamed: JACK2.3, R2.2
unnamed: JACK3.3, R3.2
unnamed: JACK4.3, R4.2
unnamed: JACK12.3, R37.2
unnamed: JACK13.3, R44.2
unnamed: P6.1, R59.2
unnamed: P6.3, R58.2
unnamed: R23.1, U1.1, U2.1
unnamed: R24.1, U1.13, U8.1
unnamed: R26.1, U3.5
unnamed: R27.1, U3.13
unnamed: R28.1, U3.1
unnamed: R47.1, R48.2, R49.2
unnamed: R55.1, SW1.L1
unnamed: R56.1, SW2.L1
unnamed: R72.1, U7.13
unnamed: R73.1, U7.14
unnamed: R5.1, R9.1, R10.2, U1.5 (+)
unnamed: R17.2, U1.4 (-)
unnamed: R7.1, R13.1, R14.2, U1.7 (+)
unnamed: R19.2, U1.6 (-)
unnamed: R8.1, R15.1, R16.2, U1.11 (+)
unnamed: R20.2, U1.10 (-)
unnamed: R6.1, R11.1, R12.2, U1.9 (+)
unnamed: R18.2, U1.8 (-)
unnamed: U3.2, U3.3
unnamed: C2.1, L1.2, U4.1 (IN)
unnamed: C11.1, U5.5 (CV)
unnamed: R29.1, R30.2, U5.7 (DIS)
unnamed: C16.1, R31.1, R33.2, U6.2 (-)
unnamed: C9.1, R51.1, R52.2, U6.6 (-)
unnamed: C8.1, P2.1, R50.1, R57.1, U6.9 (-)
unnamed: C17.1, R32.1, R34.2, U6.13 (-)
unnamed: R45.1, R62.1, R63.2, U7.5 (+)
unnamed: R66.2, U7.4 (-)
unnamed: R46.1, R64.1, R65.2, U7.7 (+)
unnamed: R67.2, U7.6 (-)
PWM_ACCENT__XOX: J2.6, U8.4
PWM_CUTOFF__XOX: D20.2 (A), J3.5, R22.1, U1.14
PWM_DECAY__XOX: J2.5, U2.4
PWM_ENVELOPE__XOX: J3.6, R21.1, U1.2
PWM_SAW__XOX: J3.2, R69.1, U7.1, U7.8 (-)
PWM_SQUARE__XOX: J3.1, R68.1, U7.2, U7.10 (-)
SAW_LEVEL: JACK13.2, P9.2
SLIDE: SW1.1, SW1.6, U3.10
SLIDE_XOX: J2.1, R55.2, SW1.2
SQUARE_LEVEL: JACK12.2, P10.2
TIMER: C14.1, R17.1, R18.1, R19.1, R20.1, R30.1, R66.1, R67.1, U5.2 (TR), U5.6 (THR)
WAVE: C1.2, J8.2
WAVE_SQUARE: J6.1
WAVE_TRI: J6.3
\ACCENT: SW2.3, SW2.4, U3.6, U3.9
\ACCENT_IN: SW2.5, U2.2
\SLIDE: SW1.3, SW1.4, U3.11, U3.12
\SLIDE_XOX: J2.2, SW1.5

Notes on the sheet:
303 INTERFACE REV3
Tune
AUDIO (IN)
WAVEFORM MIX
Decay
VCF (AUDIO OUT)
AUDIO OUTPUTS (+ FM CUTOFF)
Cutoff
CV/GATE INPUTS
POWER
TIMER (generates a square signal, that will be used to convert analog potentiometers voltages to digital TTL voltages)
FM CUTTOF (audio vca to audio cutoff) amplifier + full-wave rectifier
VCA (AUDIO OUT)
Resonnance (+ res accent)
SAW LEVEL (CV IN)
R71
ENVELOPE MOD (CV IN)
SQUARE LEVEL (CV IN)
X0X-HEART connectors
SLIDE (GATE IN)
DECAY (CV IN)
Interface for the openmusiclabs xOx-heart motherboard based on the openmusiclabs xOx-heart pacemaker schematic
Mechanical holes (for screwdriver)
Env Modulation
18mA (max)
DIRECT CONTROLS TO X0X-HEART
PITCH (CV IN)
ACCENT (CV IN)
CUTOFF (CV IN)
Volume
ACCENT (GATE IN)
GATE (GATE IN)
Accent
External audio input (to filter)

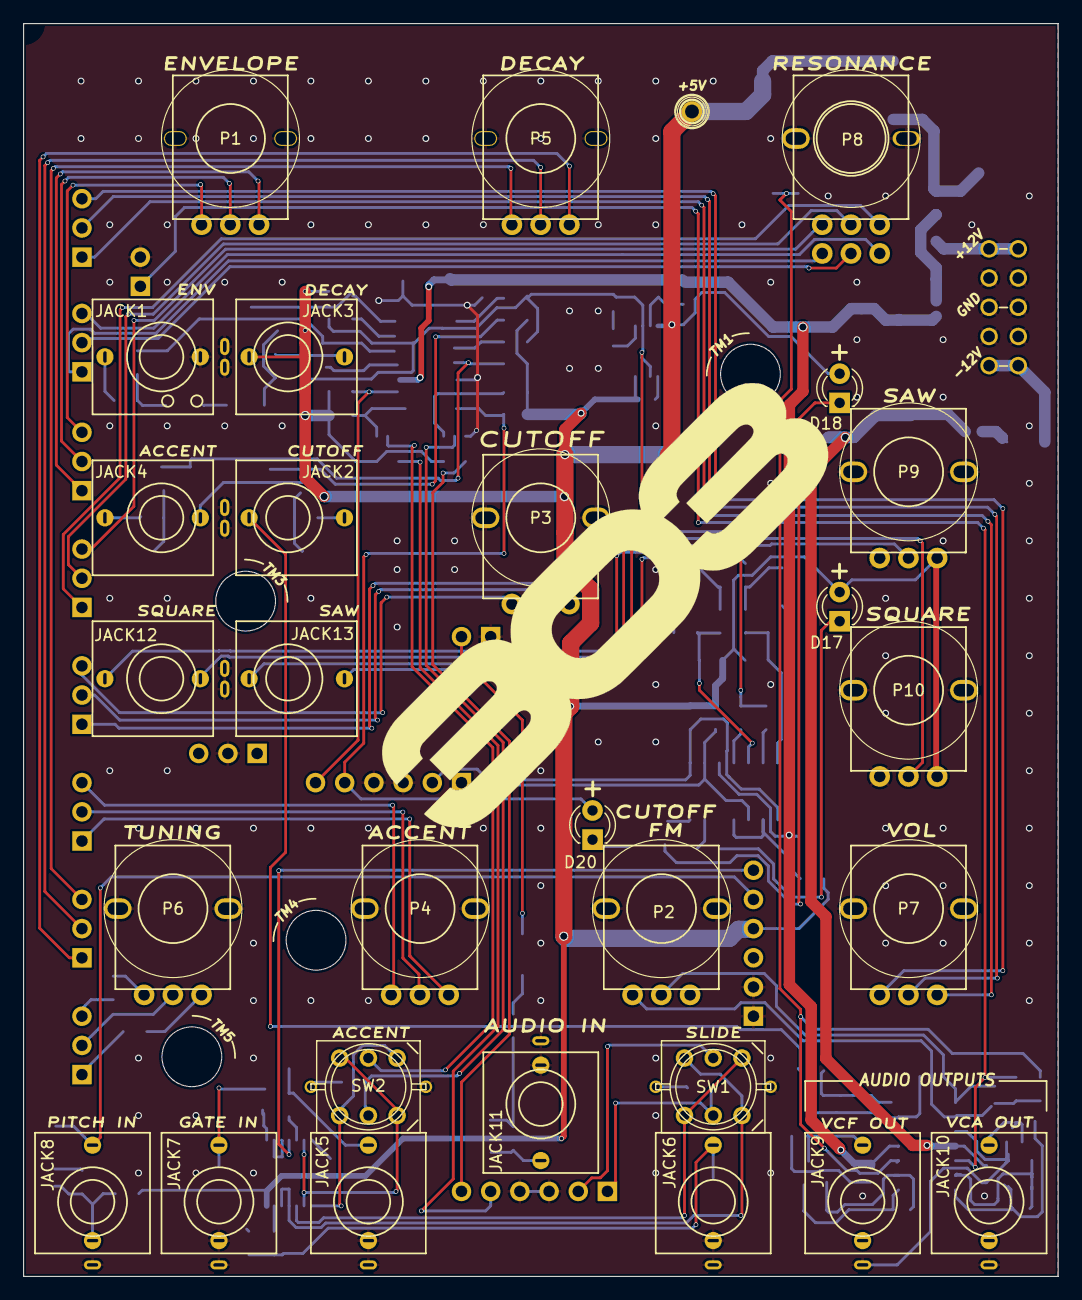
[picture p27: board 303.kicad_pcb from above]

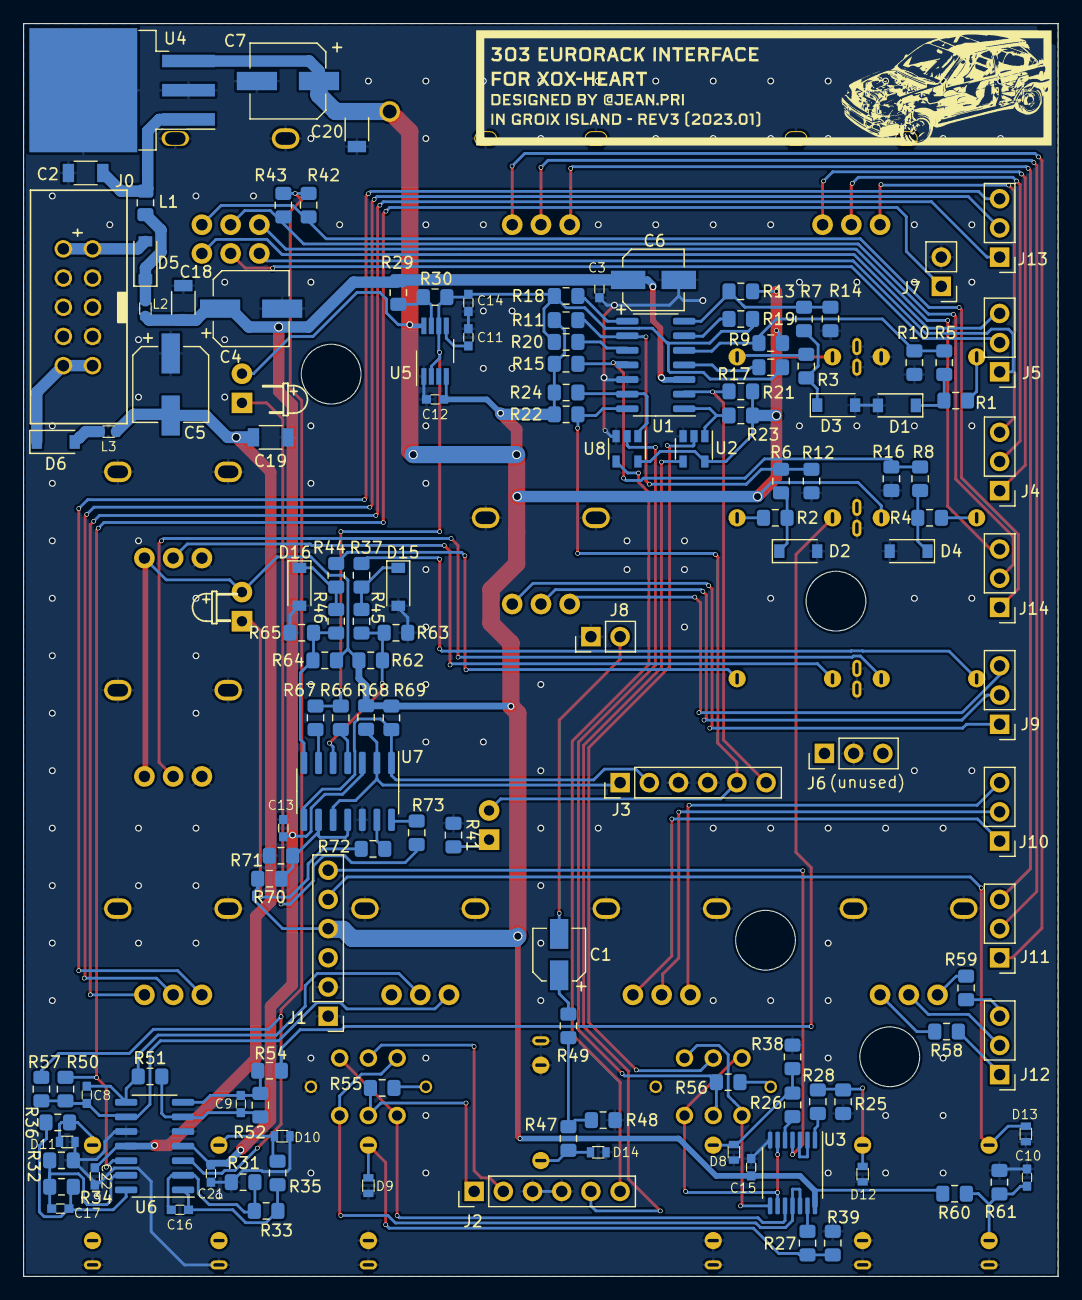
[picture p28: board 303.kicad_pcb from below]

Board: 2 copper layers, 90.0 x 109.0 mm, 166 parts (134 on the bottom side), 115 nets.
